SelimSlymn/lpda-300-1000MHz/fabrication/assembly_guide.html

# LPDA 300–1000 MHz — fabrication and assembly guide

20 elements · Ø10 mm aluminium elements · 15×15×1.5 mm square-tube booms · 7.5 mm boom gap · RG-316 inside boom A (infinite balun) · axial M4 bolts on both booms

3D modelCross-sectionHole listCut listMaterials and toolsFabrication stepsChecks and measurementCST model

Verified in CST (11 Nov 2026): 20 elements, Ø10 elements, gap 7.5 mm, shorting plate on the top face. S11 < −10 dB across 300–1000 MHz (worst −10.1 dB at 957 MHz), VSWR ≤ 1.91, gain 9.0–9.5 dBi, front-to-back ratio 22–30 dB. The lengths in the cut list are final.

## 3D model

Exploded view Make booms transparent Show holes

Aluminium boom Ø10 element rod M4×25 element bolt M3×25 plate bolt POM, nylon RG-316 Lug, centre conductor

Ø4.5 element bolt / spacer Ø3.2 plate bolt Ø3.5 coax exit Ø5.0/Ø6.0 rivet nut

Drag to rotate · wheel or two-finger pinch to zoom · right-click or two-finger drag to pan · click a part to see its dimensions on the right.

#### Click a part

Boom, element, bolt, screw, spacer, coax, lug or hole — the dimensions, material, hole and connection of the clicked part are shown here. In "Show holes" mode every hole can be clicked individually.

## Cross-section

This section is taken perpendicular to the boom axis at an element position (here an odd-numbered element). The method is the same on both booms: the rod end sits on the boom face, and an M4×25 bolt entering from the opposite face screws into the M4 thread in the rod end. On odd-numbered elements the A arm points up and the B arm down; on even-numbered elements the other way round. The RG-316 runs along the upper outer corner of boom A; the bolts pass through the centre, so they do not clash. Scale approximately 6 px = 1 mm.

## Hole list

All z dimensions are measured from the rear end of the boom (z = 0). To avoid accumulating errors, always mark each hole from z = 0, never from the previous hole. "Centre" means the middle of the face. Faces are defined with the booms side by side and the elements vertical: top/bottom are the faces the elements stick out of, outer side is the face that does not face the gap.

Code | Where | Diameter / thread | Qty | Position | Note
D1 | Boom A and boom B, top and bottom faces | Ø4.5 | 2 booms × 20 × 2 walls | Element z positions, face centre | Clamp both booms side by side and mark them at the same z. Drill both walls of each boom in one pass, square, on a drill press
D5 | One end of every rod | Ø3.3 × 12–13 → M4 thread | 40 | Rod axis | Centre on a lathe or with a drill guide block. Square the end face first
D6 | Both booms + POM, horizontal | Ø4.5 | 6 | z = 69.4 · 348.1 · 682.6 · 1051.0 · 1268.6 · 1353.6; mid-height | Drill all four walls in one pass with the POM between the booms
D7 | Boom A, top face | Ø3.5 | 1 | z = 1395, 4 mm outward from the axis | Coax exit. Deburr thoroughly
D8 | Boom A, top face | Ø5.0 (M3 rivet nut) | 1 | z = 1401, centre | Shield lug
D9 | Boom B, top face | Ø5.0 (M3 rivet nut) | 1 | z = 1398, centre | Centre-conductor lug
D10 | Booms A and B, top and bottom faces + plate | Ø3.2 | 2 booms × 2 walls + 2 in the plate | z = 7.5, face centre; 22.5 mm between the plate holes | Shorting plate, M3×25 through-bolts + washer + nylon-insert nut
D11 | Boom B, outer side face | Ø6.0 (M4 rivet nut) | 2 | z = 660 and 705, mid-height | Mounting plate. The middle spacer bolt (z 682.6) also passes through the plate

## Cut list

Two rods of equal length are cut for every element, one for A and one for B. Cut length = h; the rod sits on the boom face, so this equals the simulated arm length. Direction: on A the odd-numbered elements point up and the even ones down; on B the opposite. Cut tolerance ±0.5 mm; take extra care with the shortest elements.

# | z (mm) | Full L (mm) | Cut h (mm) | Qty | A direction | B direction | f res. (MHz)

Total rod ≈ 2 × 2289 = 4.58 m. With saw allowance, buy 5–6 m of Ø10 solid aluminium rod. Booms: 2 × 1407.3 mm. Approximate total weight 1.6 kg, centre of gravity at z ≈ 720 mm.

## Materials and tools

Part | Size | Qty | Note
Square tube (6060/6063) | 15×15×1.5, 1407.3 mm | 2 | If anodized, sand the contact points. A 1 mm wall also works.
Solid aluminium rod (preferably 6061/6082) | Ø10 | 5–6 m | Not tube: an axial thread cannot be cut in a tube.
Stainless bolt (DIN 912 or 933) | M4×25 + DIN 125 washer | 40 (+5 spare) | All elements on both booms
Nylon bolt + nut + washer | M4×45 (1 × M4×60) | 6 | Spacers. The long one is for spacer 3 and also passes through the mounting plate.
POM (Delrin) spacer | 7.5×15×25 | 6 | Machine down from 8 mm sheet to 7.5, or simulate gap = 8 in CST.
Shorting plate (Al) | 37.5×15×3 | 1 | 2 × M3×25 + serrated washer + washer + nylon-insert nut
M3 rivet nut + M3×6 screw | Ø5.0 hole | 2 | Feed lugs
M3 ring lug (solderable) | — | 2 | Copper / tinned
RG-316 coax | Ø2.5 | ~1.8 m | 1.4 m inside the boom + allowance at the rear
SMA or N connector | for RG-316, crimp | 1 | Rear end
Mounting plate (POM/PVC) | 75×60×10 | 1 | 2 × M4 rivet nut (Ø6.0) + mast U-bolt
Heat-shrink tubing, silicone | Ø3–6 | — | Sealing the feed and connector

Tools: drill press and vice, V-block; drill bits Ø3.2, 3.3 (3–4 pcs), 3.5, 4.5, 5.0, 6.0, 10 (for the guide block); 3-piece M4 hand tap set and tap wrench; cutting oil; countersink / deburring tool; calipers, square, scriber, centre punch; band saw or fine-tooth hacksaw for aluminium; file, sandpaper; rivet-nut tool; soldering iron; multimeter; NanoVNA or VNA. If a lathe is available, have the 40 rod ends done there.

## Fabrication steps

1. Cut the booms. Cut both tubes to 1407.3 mm. Ends square, deburred. Write "A" and "B" on the booms with a permanent marker and mark the rear end (z = 0).
2. Cut and number the rods. Following the cut list, cut two rods of length h for every element, 40 rods in total. Label them A01…A20, B01…B20 with tape.
3. Square the rod ends. File the end of each rod that will sit on the boom, then square it on sandpaper fixed to glass. The element rests on the boom face with this end; if the end is skewed, the element will be too.
4. Tap an axial M4 thread in the rods (D5).
  - With a lathe: face the end, centre-drill, drill Ø3.3 to 13 mm, and tap by hand with the tap supported by the tailstock.
  - Without a lathe, make a guide block: in a ~30 mm thick block, without moving it, drill Ø3.3 all the way through and then Ø10 to 22 mm depth from the same side. Hold the rod upright in the vice, slip the block over its end with the Ø10 side, and drill Ø3.3 through the guide hole 12–13 mm into the rod.
  - Put the tap in the drill chuck and, with the drill switched off, start it by hand for 2–3 turns; then continue with the tap wrench, one turn forward and half a turn back. Use cutting oil. Run the taper, intermediate and bottoming taps in order.
  - Check every rod by turning an M4×25 bolt fully in by hand.
5. Mark the element positions. Clamp both booms side by side with their rear ends aligned. Fix the tape measure at z = 0 and draw all 20 positions across the top faces of both booms with a square in one go; centre-punch each line at the middle of the face. Take every measurement from z = 0, not from the previous hole.
6. Drill the element holes (D1). Lay each boom in the vice on the drill press and check with a square that the drill is perpendicular. At every mark drill Ø4.5 through the top and bottom walls in one pass. 20 holes in each boom. Deburr.
7. Prepare the spacers. Cut 6 POM blocks of 7.5×15×25 mm. Measure the thickness (gap) with calipers; it should be 7.5 ± 0.2 mm.
8. Drill the spacer holes (D6). Clamp the two booms with the POM blocks between them at the correct z positions. At every spacer position drill Ø4.5 at mid-height through all four walls and the POM in one pass.
9. Front-end holes (D7–D9). On the top face of boom A at z = 1395, 4 mm from the axis towards the outer edge, drill the Ø3.5 coax exit hole and deburr it carefully. Drill Ø5.0 holes at z = 1401 on the top face of boom A and at z = 1398 on the top face of boom B and set M3 rivet nuts.
10. Shorting plate (D10). Cut a 37.5×15×3 aluminium plate and drill Ø3.2 holes near both ends, 22.5 mm apart centre to centre. On each boom, 7.5 mm in from the rear end, drill Ø3.2 through both walls at the centre of the top face.
11. Mounting plate (D11). Drill Ø6.0 holes at z = 660 and 705 on the outer side face of boom B and set M4 rivet nuts. Drill Ø4.5 holes in the POM mounting plate at the same spacing and at z = 682.6 (spacer 3 bolt).
12. Clean the contact surfaces. On anodized tube, sand to bare metal around the element holes (where the rod end sits) and where the plate and lugs sit. Also polish the threaded end faces of the rods.
13. Join the booms. Insert the POM spacers, fit the nylon M4 bolts and tighten by hand. Measure the gap with calipers at several points. Multimeter: A to B must be open (∞ Ω).
14. Pull the RG-316. Push a thin wire in from the open rear end of boom A and out through the Ø3.5 hole at the front, tie the coax to it and pull it through. Leave ~3 cm at the front and ~30 cm at the rear. Lay the cable in the upper outer corner.
15. Fit the elements. Seat the threaded end of each rod over its hole: on A the odd-numbered elements on the top face and the even ones on the bottom face; on B the other way round. Pass an M4×25 bolt with washer from the opposite face and screw it into the rod. On boom A check that the coax stays in the corner before tightening. Hand-tight, do not overtighten. Check with a square that each element is perpendicular to the boom.
16. Fit the shorting plate. Place the plate on the top faces of both booms at the rear end. Pass the M3×25 bolts through serrated washer, plate and boom, and tighten from below with a washer and nylon-insert nut. Multimeter: A to B is now a short circuit. This is normal for an LPDA.
17. Connect the feed.
  - Strip ~10 mm of the jacket from the coax coming out of the Ø3.5 hole. Twist the braid into a single lead and solder it to an M3 ring lug; fix the lug with an M3×6 screw to the rivet nut on boom A (z = 1401).
  - Keep the PTFE insulation of the centre conductor up to 2–3 mm from the lug, solder its end to the second lug and fix the lug to the rivet nut on boom B (z = 1398).
  - Keep the exposed conductor ends shorter than 10 mm. Solder does not wet aluminium; solder only to the lugs.
  - Protect the joint from moisture with heat-shrink tubing and neutral-cure silicone.
18. Fit the connector. Crimp an SMA or N connector onto the RG-316 at the rear end. Multimeter: you should see a short circuit between the centre pin and the body of the connector (centre conductor → boom B → plate → boom A → braid). This is correct.
19. Fit the mounting plate. Bolt the POM plate to the rivet nuts on the outer side face of boom B with M4 bolts; the long nylon bolt of spacer 3 also passes through the plate. Attach the mast to the plate with a U-bolt. A metal mast must not be parallel to the elements: if the elements are vertical, offset the mast by at least 30–40 cm with a horizontal plastic arm, or rotate the antenna by 90° and use horizontal polarization.

## Checks and measurement

- Mechanical: All elements must be perpendicular to the booms and in one plane. The gap must be the same everywhere. No screw may protrude into the gap, and no metal part may bridge the two booms at the front.
- Electrical (multimeter):
  - Before the plate is fitted, A–B must be open.
  - After the plate is fitted, A–B must be a short circuit.
  - Every rod must be shorted to its own boom and open to the other boom.
  - At the connector, centre pin to body must be a short circuit.
- RF (NanoVNA): Calibrate at the end of the measurement cable and sweep 250–1100 MHz. Keep the front of the antenna clear, at least 2 m above the ground and away from metal. Compare the result with the S11 from CST.
  - If the measured curve is above the simulation across the whole band (poorer match), first shorten the feed leads.
  - If that is not enough, change the gap by 0.5 mm.
  - If the match is poor only at the top end (900–1000 MHz), the feed point and the connection lengths at the front end are the likely cause.

## CST model

The CST model (cst/lpda.cst) matches this guide: d_el = 10, elements 21–22 removed, shortplate moved to the top face (Xrange -xA-a/2…xA+a/2, Yrange a/2…a/2+3, Zrange 0…15), gap = 7.5. Results are in results/final_20el_d10: lpda_20el_d10.s1p, the farfield tables and performance_table_d10.csv.

The dimensions in this guide are taken from the lpda.cst parameters: τ = 0.90, σ = 0.13, L1 = 555.2 mm, a = 15, gap = 7.5, stub = 138.8, front = 20, feed_back = −5, with elements 21 and 22 removed and d_el = 10.
