SelimSlymn/lpda-300-1000MHz/performance_table.csv

freq_MHz | peak_realized_gain_dBi | front_to_back_dB | hpbw_E_deg | hpbw_H_deg
300 | 9.41 | 29.8 | 59 | 82
435 | 9.47 | 27.4 | 58 | 81
600 | 9.51 | 26.1 | 58 | 80
750 | 9.50 | 22.9 | 60 | 84
870 | 8.99 | 22.7 | 62 | 89
1000 | 9.14 | 22.0 | 57 | 83
