SelimSlymn/lpda-300-1000MHz/results/final_20el_d10/performance_table_d10.csv

freq_MHz | peak_realized_gain_dBi | front_to_back_dB | hpbw_E_deg | hpbw_H_deg
300 | 9.41 | 29.8 | 59 | 82
435 | 9.47 | 27.4 | 58 | 81
600 | 9.51 | 26.1 | 58 | 80
750 | 9.50 | 22.9 | 59 | 84
870 | 8.99 | 22.7 | 61 | 89
1000 | 9.14 | 22.0 | 57 | 83
